mstratman/relay-bypass/attic-v1/relay-bypass-schematic.png

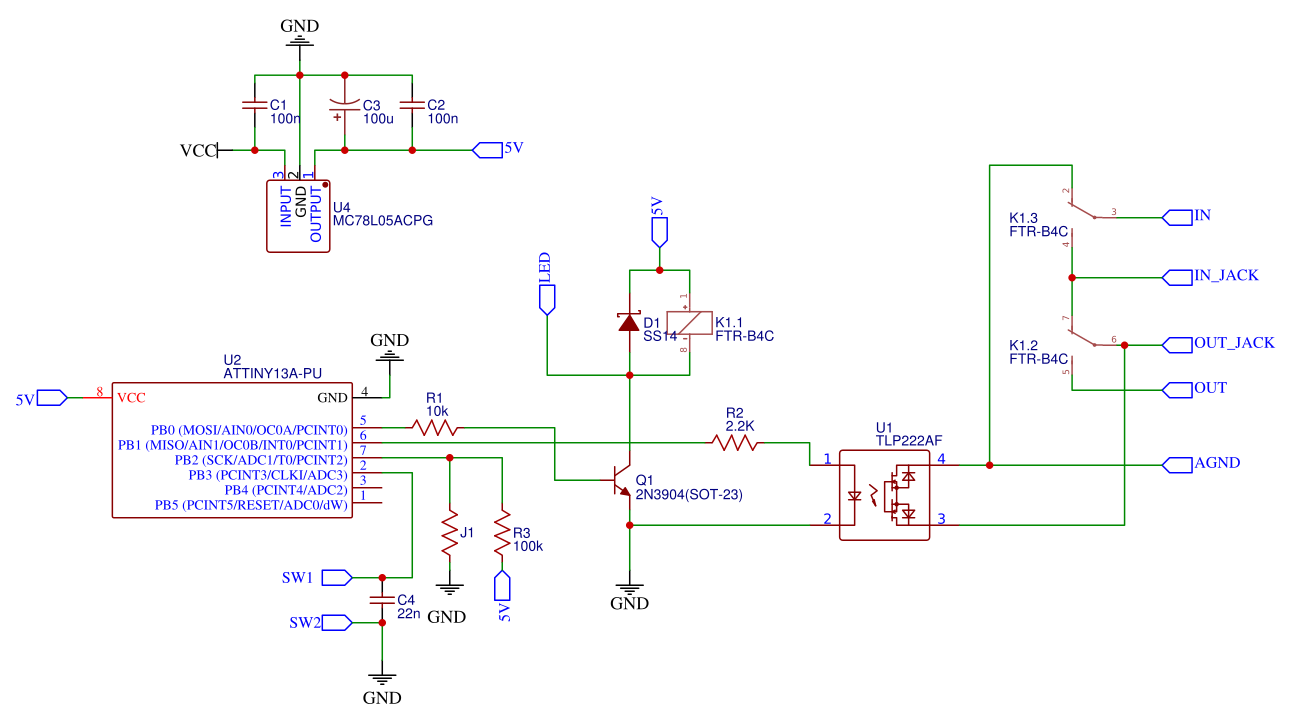
attic-v1/relay-bypass-schematic.png
