mstratman/relay-bypass/attic-v1/relay-bypass-layout-back.pdf

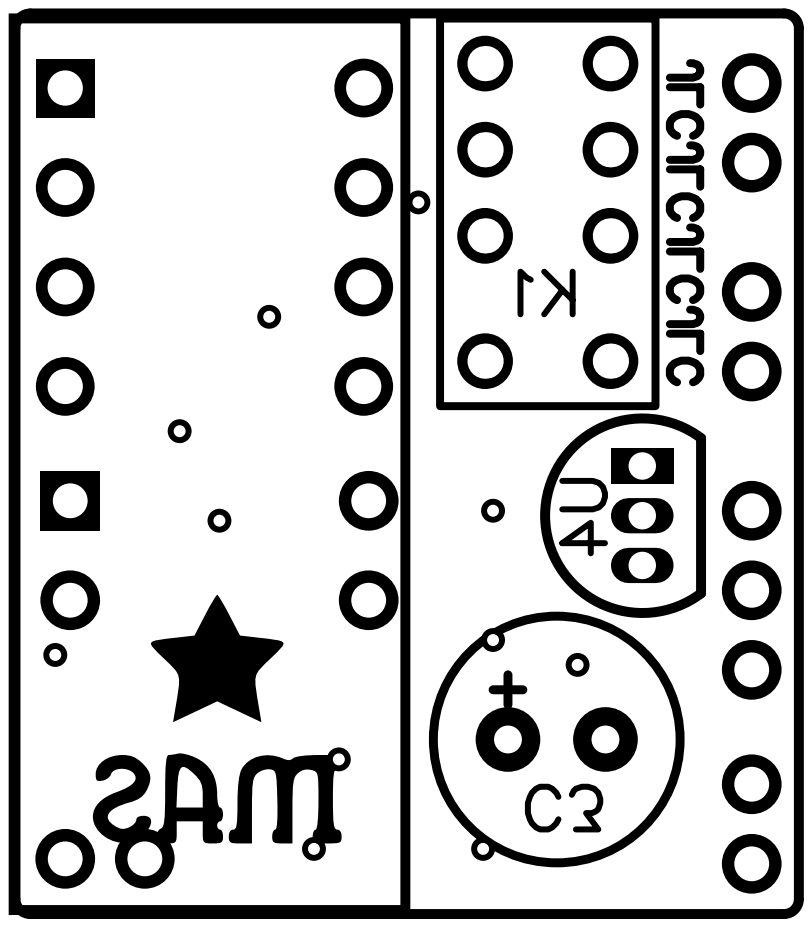
[picture p20: page 1]
