mstratman/relay-bypass/attic-v1/relay-bypass-layout-front.pdf

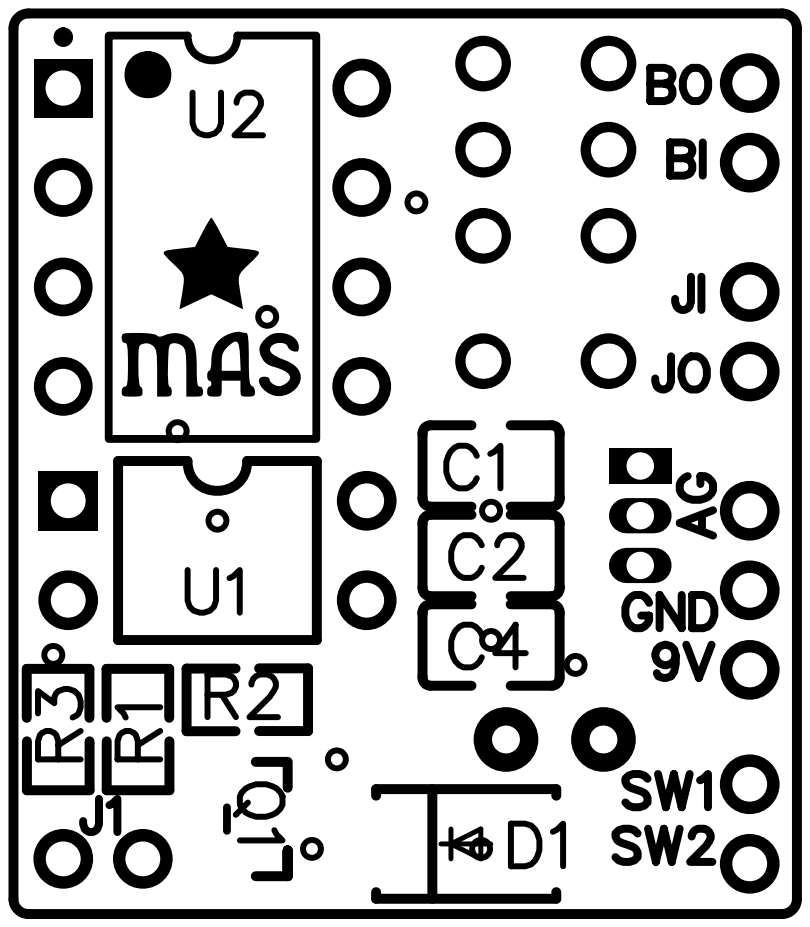
[picture p21: page 1]
