mstratman/relay-bypass/(commit log)

2020-12-04 added code, schematics, gerber, etc
    [relay-bypass-BOM-1.2.csv, relay-bypass-BOM.csv]
2020-12-04 renamed v1 to be clearer
    [relay-bypass-BOM.csv]
2020-12-04 Note that you can use either an attiny13 or attiny85
    [relay-bypass-BOM-1.2.csv]
2020-12-12 allow the use of normally closed switches
2021-02-03 clarify non-latching
    [relay-bypass-BOM-1.2.csv]
2021-03-17 added latching version of the relay
    [relay-bypass-BOM-1.2.csv, relay-bypass-BOM-1.3.csv]
2021-03-17 added shell script to write fuses
2021-08-08 added v1.4
    [relay-bypass-BOM-1.3.csv, relay-bypass-BOM-1.4.csv, relay-bypass-pickandplace-1.4.csv]
2022-02-24 remove unnecessary (and wrong) initial values...
    Shouldn't cause a problem but can be misleading since actual values
    for HIGH can be a variety of non-zero values
    [relay-bypass.ino]
2023-06-15 corrected pins on relay in schematic
2023-06-15 fixed bad schematics
2023-07-17 Updated instructions
    [relay-bypass-BOM-1.4.csv, relay-bypass-pickandplace-1.4.csv]
